frahncky/EMetrics-IoT/firmware/esp32_pzem/README.md

# ESP32 + PZEM-004T (MQTT)

Exemplo de firmware com provisionamento via AP local para receber Wi-Fi e MQTT direto do app.

## Estrutura

- esp32_pzem.ino

## Payload publicado

```json
{
  "voltage": 220.1,
  "current": 0.51,
  "power": 112.0,
  "pf": 0.98,
  "frequency": 60.0,
  "energy": 1.23,
  "temperature": 42.1,
  "crcErrors": 0,
  "timestamp": 1746316850000,
  "sequence": 7,
  "timeSynced": true,
  "storage": {
    "usingSd": true,
    "sdAvailable": true,
    "sdUsedBytes": 1048576,
    "sdTotalBytes": 33554432,
    "sdUsagePercent": 3.12
  }
}
```

- `timestamp` é o instante da medição em epoch de milissegundos. Vale `0`
  enquanto o NTP ainda não sincronizou; nesse caso `timeSynced` é `false`.
- `sequence` cresce a cada leitura e reinicia quando o ESP é reiniciado.
- `temperature` vale `null` quando a variante da placa não oferece sensor interno.

## Provisionamento pelo app

Quando o ESP nao tem configuracao salva, ele sobe em AP:

- SSID: EMetrics-Setup
- Senha: 12345678
- Endpoint de verificacao: GET /health
- Endpoint de configuracao: POST /provision

Campos esperados em /provision (form-urlencoded):

- ssid
- wifiPassword
- mqttHost
- mqttPort
- mqttUser
- mqttPassword
- mqttTopic
- mqttRequestTopic
- clientId
- useTls (1 ou 0)
- initialConnectTimeoutSeconds, retryIntervalSeconds e fallbackApDelaySeconds
  (opcionais; de 5 a 600 segundos)

O ESP32 tambem salva a rede Wi-Fi enviada em uma lista local. O app pode
gerenciar essa lista quando estiver conectado ao AP do ESP ou ao IP do ESP na
rede local:

- GET `/wifi-networks`: lista redes salvas.
- POST `/wifi-networks`: cria ou edita uma rede (`ssid`, `wifiPassword`,
  `oldSsid` opcional, `keepPassword` 1 ou 0).
- POST `/wifi-networks/delete`: exclui uma rede (`ssid`).
- POST `/wifi-networks/reorder`: muda a prioridade de uma rede (`ssid` e
  `direction`, com `up` ou `down`).
- GET `/wifi-connection-settings`: retorna os tempos de conexão Wi-Fi.
- POST `/wifi-connection-settings`: atualiza `initialConnectTimeoutSeconds`,
  `retryIntervalSeconds` e `fallbackApDelaySeconds` (de 5 a 600 segundos) e
  reinicia o ESP para aplicar a tentativa inicial.

O firmware mantém ate 5 redes salvas e tenta reconectar alternando entre elas
quando o Wi-Fi cai. A ordem exibida no app define a prioridade: a primeira
rede é sempre a primeira tentativa do próximo ciclo.

## AP de fallback

Depois da primeira configuracao, o ESP continua iniciando o servidor HTTP local.
Os valores padrão são: 20 segundos para a tentativa inicial, 15 segundos entre
tentativas e 60 segundos para ativar o AP de fallback. Eles podem ser alterados
no app, entre 5 e 600 segundos. Se o ESP ficar pelo tempo configurado sem
conseguir conectar em uma rede salva, ou se a lista de redes ficar vazia, ele
abre automaticamente o AP `EMetrics-Setup` em modo AP+STA. Nesse modo:

- O ESP continua tentando conectar nas redes salvas.
- O app pode acessar `http://192.168.4.1` para editar ou excluir redes.
- Ao reconectar na rede configurada, o AP de fallback e desligado sozinho.

Se o ESP iniciar sem nenhuma configuracao valida, ele entra no modo de
provisionamento inicial e permanece somente como AP ate receber `/provision`.

## Atualização de firmware por Wi-Fi (OTA)

A primeira gravação deste firmware ainda precisa ser feita via USB. Depois
disso, há duas formas de atualizar sem cabo:

### 1. Pelo Arduino IDE (ArduinoOTA)

Após a gravação inicial e o provisionamento do Wi-Fi, o ESP32 aparece
automaticamente como porta de rede no Arduino IDE:

**Tools > Port > `<clientId>` at `<IP>`**

Basta selecionar essa porta e clicar em **Upload** normalmente. Se a
`otaPassword` foi definida no provisionamento (8 a 64 caracteres), o IDE
solicitará a senha na primeira vez — informe a mesma chave. O hostname
exibido no IDE é o `clientId` definido no provisionamento (padrão:
`esp32_pzem_001`).

> **Requisito:** computador e ESP32 na mesma rede local.

### 2. Pelo app Flutter (HTTP OTA)

O firmware também expõe `POST /firmware/update` para receber um `.bin`
gerado para o ESP32. O app pode selecionar um `.bin` e enviá-lo pela rede
local. Cada upload deve enviar a chave OTA no cabeçalho HTTP
`X-EMetrics-OTA-Key`; sem ela, o ESP recusa a atualização.

Para gerar um binário com Arduino CLI:

```bash
arduino-cli compile --fqbn esp32:esp32:esp32 --export-binaries firmware/esp32_pzem
```

Use uma tabela de partições com duas partições OTA. O esquema padrão usado pelo
core ESP32 possui espaço para a atualização, desde que o `.bin` caiba na
partição de aplicação.

## Robustez incluida neste exemplo

- Configuracao persistida em NVS (Preferences)
- Reconexao nao bloqueante de Wi-Fi e MQTT
- AP de fallback para recuperar o acesso local quando a rede configurada cai
- Fila circular em RAM para segurar amostras durante queda do broker
- Envio em lote apos reconexao
- Historico persistente em cartao microSD (Adafruit) para replay sob demanda
- Fallback automatico para SPIFFS quando o cartao SD nao estiver disponivel
- Assinatura no topico de solicitacao de historico e reenvio por intervalo
- Suporte a MQTT com TLS (WiFiClientSecure)

## Armazenamento local (microSD Adafruit)

Por padrao, o firmware tenta iniciar o cartao SD no barramento SPI com os pinos:

- CS: `14`
- SCK: `18`
- MISO: `19`
- MOSI: `23`

Se sua placa usar outro mapeamento, altere no topo do arquivo `esp32_pzem.ino` via defines:

- `EMETRICS_SD_CS_PIN`
- `EMETRICS_SD_SCK_PIN`
- `EMETRICS_SD_MISO_PIN`
- `EMETRICS_SD_MOSI_PIN`

O arquivo de historico fica em `/history.log` e e usado para responder requisicoes de historico por intervalo.
O app tambem exibe o percentual de uso do SD a partir do campo `storage.sdUsagePercent`.

## Parametros de buffer (esp32_pzem.ino)

- TELEMETRY_QUEUE_CAPACITY: quantidade maxima de amostras na fila
- FLUSH_BATCH_LIMIT: quantas amostras enviar por iteracao do loop
- TELEMETRY_PAYLOAD_SIZE: tamanho maximo do JSON em bytes
- MQTT_BUFFER_SIZE: buffer do PubSubClient, incluindo JSON, tópico e cabeçalhos MQTT

Quando a fila lota, a amostra mais antiga e descartada para abrir espaco.

## Dependencias (Arduino IDE)

- WiFi (core ESP32)
- WebServer (core ESP32)
- Preferences (core ESP32)
- PubSubClient
- PZEM004Tv30

## Fluxo de uso

1. Grave o firmware no ESP32.
2. Conecte o celular na rede EMetrics-Setup.
3. No app, abra Configuracoes > MQTT > Provisionar ESP32.
4. Envie SSID/senha da rede final e dados do MQTT.
5. O ESP reinicia e passa a operar no modo normal.

## Controle pelo dashboard web

O botão **Iniciar nova leitura** fica no topo do dashboard. Ele limpa os
valores, gráficos, alertas e amostras da sessão atual no navegador e começa
uma nova coleta MQTT, sem apagar o histórico persistido no ESP32. Não é
necessário informar o endereço IP do dispositivo na interface web.

O painel também permite iniciar, pausar, retomar ou encerrar uma sessão de
coleta por um período definido em segundos. Esses controles registram as
leituras no gráfico do navegador e não interrompem a publicação MQTT do ESP32;
assim, pausar a coleta não acumula mensagens na fila do dispositivo.

## Observacao sobre QoS

Nesta implementacao (PubSubClient), a publicacao de payload usa QoS 0.
O app Flutter permanece compativel, pois consome o JSON publicado no topico configurado.

## Solicitar historico via MQTT

O firmware assina o topico configurado em `mqttRequestTopic` e espera o payload JSON:

```json
{
  "from": 1746230400000,
  "to": 1746316800000,
  "requestedAt": 1746316850000
}
```

Ao receber essa solicitacao, o ESP32 filtra os registros persistidos no intervalo `from`/`to`
e republica os payloads no topico principal de telemetria (`mqttTopic`).

## Configurar retencao do SD via MQTT

O mesmo topico `mqttRequestTopic` aceita um comando para ajustar por quantos dias o
historico fica armazenado no SD do medidor:

```json
{
  "command": "configureStorage",
  "sdRetentionDays": 30,
  "requestedAt": 1746316850000
}
```

O valor aceito fica entre 1 e 3650 dias. O firmware salva a configuracao em NVS
e remove registros do arquivo `/history.log` mais antigos que o periodo configurado.

## Observacao sobre TLS

Com `useTls=1`, o firmware usa `WiFiClientSecure` com `setInsecure()`.
Isso ativa criptografia de transporte, mas sem validacao de certificado do broker.
Para ambiente produtivo com validacao estrita, substitua por CA/certificado apropriado.
