frahncky/EMetrics-IoT/firmware/tabela_conexao.jpeg

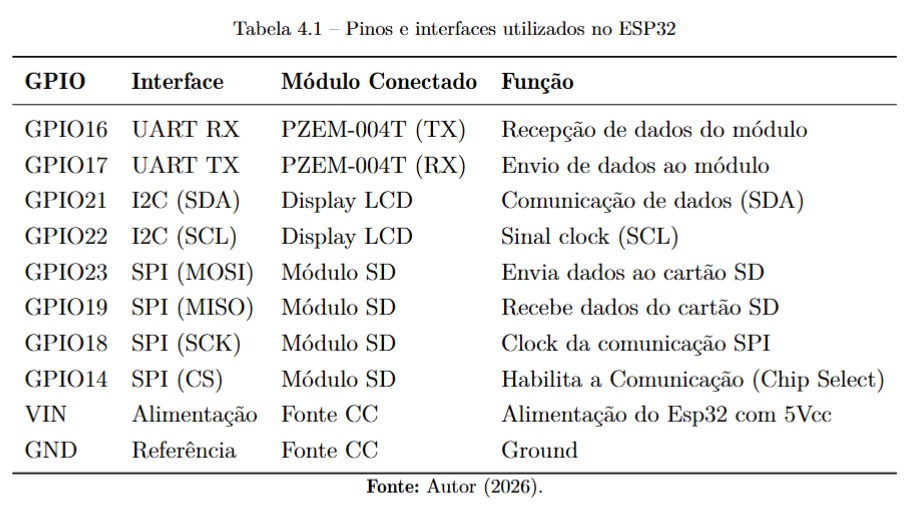
firmware/tabela_conexao.jpeg
