frahncky/EMetrics-IoT/imagens/PCB_design.png

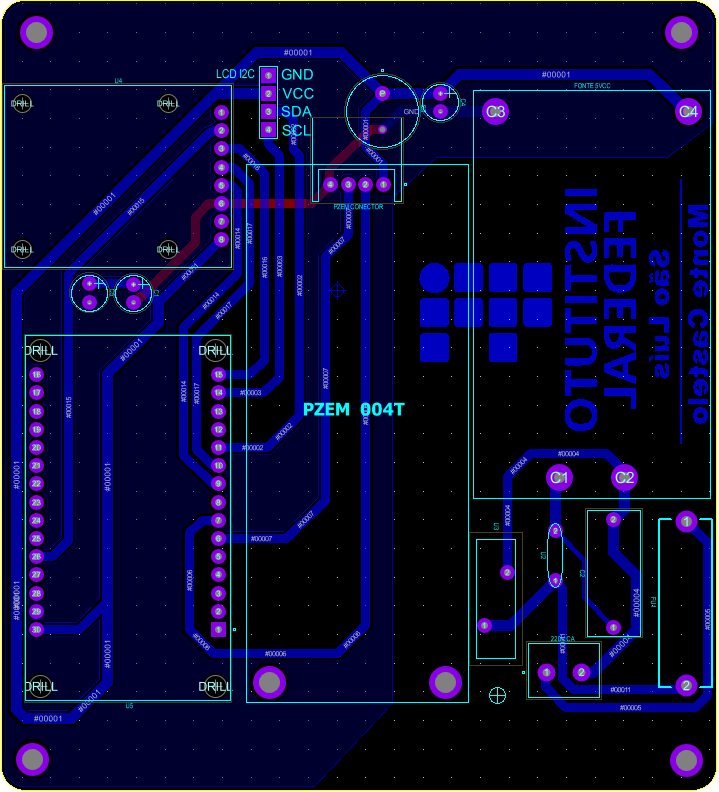
imagens/PCB_design.png
