frahncky/EMetrics-IoT/model_3D/Assembly 1.step

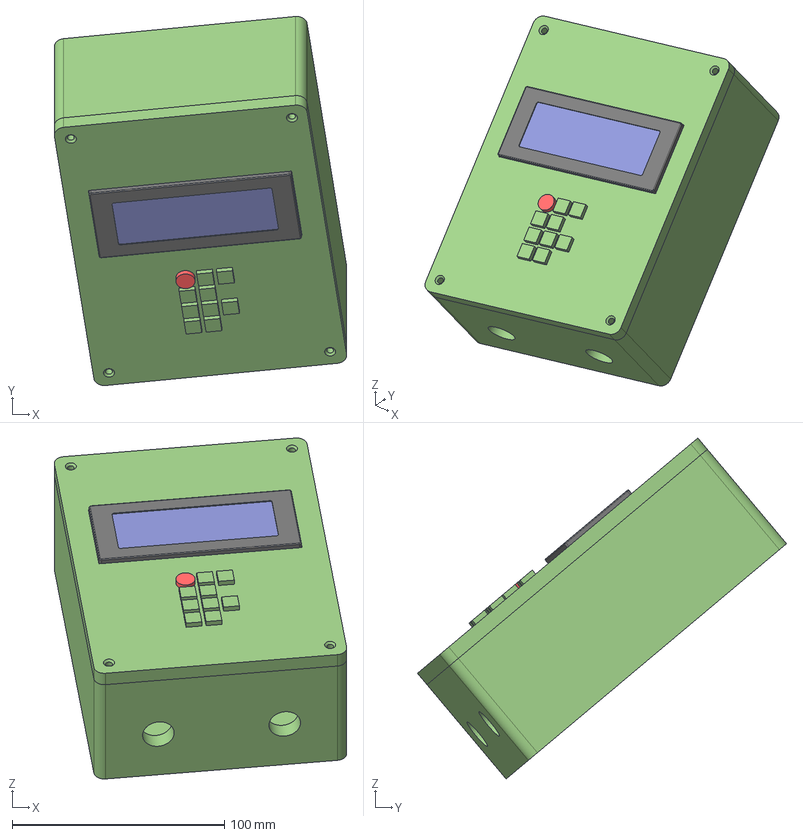
[picture p7: CAD file, 2026-07-03]
model_3D/Assembly 1.step
137.7 x 173.9 x 160.7 mm
4 way header curved x 4
20x4 LCD x 10
2 way header curved x 2
I2C LCD Adapter PCF8574
