frahncky/EMetrics-IoT/model_3D/Base.step

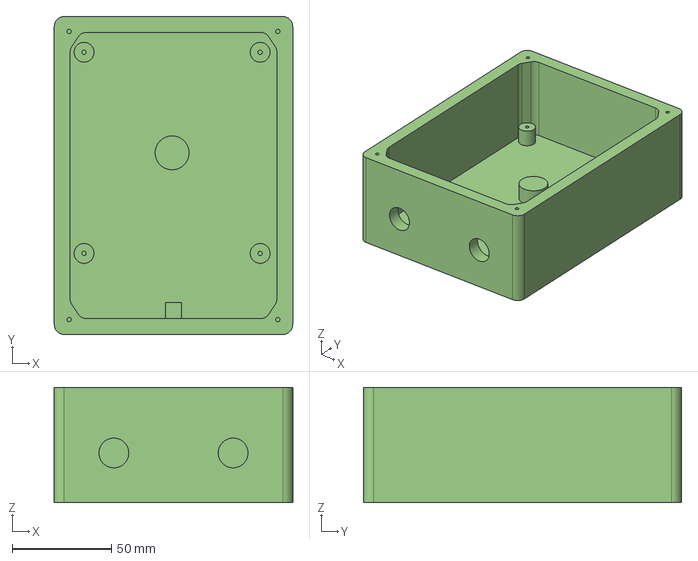
[picture p8: CAD file, 2026-07-03]
model_3D/Base.step
120.0 x 160.0 x 58.0 mm
