frahncky/EMetrics-IoT/imagens/montagem-case.png

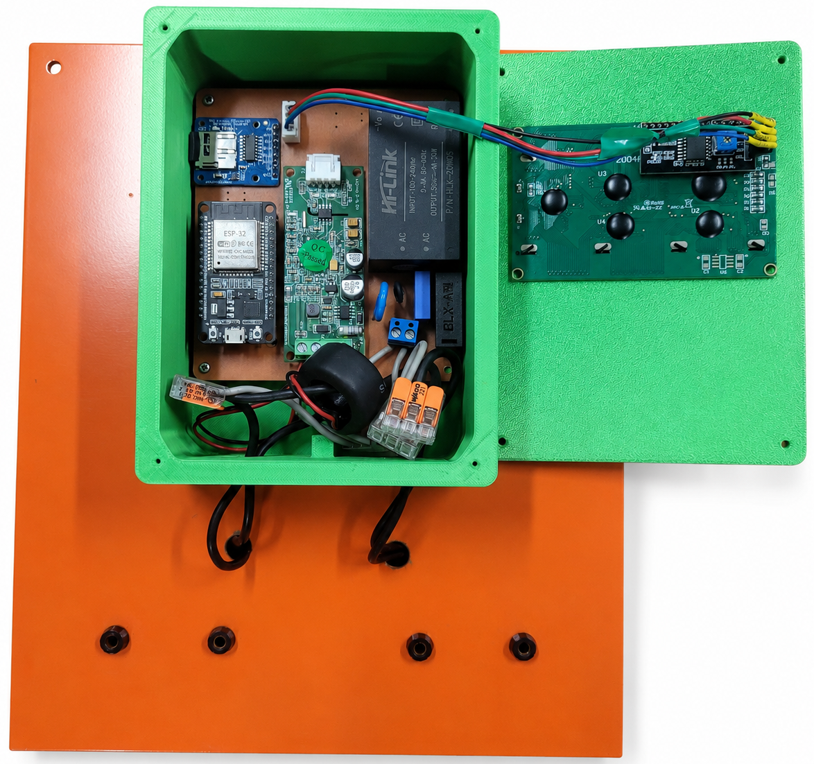
imagens/montagem-case.png
