frahncky/EMetrics-IoT/(list of files, drawings)

Other design files:
projeto_medidor_proteus/Medidor5_devikitV1.pdsprj
