frahncky/EMetrics-IoT/(commit log)

2026-04-28 Corrige erros de importação, nome de classe e estrutura do app principal. Ajusta teste para usar EmetricsApp.
2026-04-28 Melhorias visuais e acessibilidade: novos cards, drawer aprimorado, página de comparação de métricas, ajustes em temas e layouts.
2026-04-29 Corrige importação do EmetricsApp no teste e prepara projeto para execução sem erros.
2026-04-29 feat: commit geral de todas as alterações
2026-04-30 fix(dashboard): ajuste de ícones dos indicadores, especialmente tensão (Icons.electrical_services)
2026-04-30 Melhorias: formatação SI dinâmica, grid dos gráficos mais visível, e padronização da exibição de valores
2026-04-30 feat: responsividade dos indicadores com Wrap para melhor visualização em telas menores
2026-04-30 Melhorias de UI: bordas arredondadas no menu inferior, destaque amarelo no ícone selecionado, ajustes de splash e ícone do app, e padronização do nome para E-Metrics IoT.
2026-04-30 Corrige destaque amarelo de fundo no ícone selecionado do menu inferior (BottomNavigationBar).
2026-05-01 feat: improve history UI and add mqtt history request flow
2026-05-01 feat: adicionar tema claro/escuro dinâmico e ajustar espaçamento de botões
    - Criar theme provider com Riverpod para controlar modo claro/escuro
    - Persistir preferência de tema em SharedPreferences
    - Definir tema claro baseado em estilo branco/azul (imagem fornecida)
    - Manter tema escuro com cores originais (preto/amarelo)
    - Remover cores hardcoded dos botões para responder ao tema dinamicamente
    - Aumentar espaçamento do botão Conectar em relação ao menu inferior
    - Rótulo do switch agora mostra 'Modo claro' ou 'Modo escuro' dinamicamente
2026-05-01 fix: adaptar cores hardcoded para usar tema claro/escuro dinamicamente
    - Alterar history_chart.dart para usar backgroundColor e cores de grid do tema
    - Alterar history_page.dart para dropdown color responder ao tema
    - Alterar realtime_chart.dart para usar theme colors em vez de hardcoded
    - Alterar dashboard_page.dart para usar scaffoldBackgroundColor e colorScheme
    - Corrigir deprecação withOpacity para withValues em todos os arquivos
2026-05-01 style: melhorar tema claro/escuro com paleta de cores moderna de qualidade visual
    Tema Claro:
    - Background: #F5F7FA (branco muito claro com tom azulado)
    - Primary: #0066FF (azul vibrante)
    - Secondary: #00B4D8 (azul cyan moderno)
    - Cards: branco puro #FFFFFF com bordas sutis
    - AppBar: branco puro com sombra de 4px
    - Inputs: melhor contraste com bordas coloridas no focus
    - Textos: cinzentos refinados para melhor legibilidade
    Tema Escuro:
    - Background: #0F1419 (preto muito escuro)
    - Primary: #00D8FF (ciano vibrante)
    - Secondary: #FFB300 (amarelo warmth)
    - Cards: #1A202C com bordas de 1px
    - AppBar: #1A202C com sombra aumentada
    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
2026-05-01 style: reduzir cansaço visual do tema claro com cores mais suaves
    Tema Claro melhorado:
    - Background: #FAFBFC (quase branco, muito suave)
    - Primary: #4A7BA7 (azul cinzento, menos vibrante)
    - Secondary: #6BA3C5 (azul suave)
    - Cards: #FFFEFB (branco com tom quente suave)
    - Textos: cinzentos mais suaves para menos contraste
    - Grid lines: muito mais sutis (6% e 3% de opacidade)
    - Sombras: reduzidas para visual mais clean
    - AppBar: sombra reduzida para 2px
    O tema claro agora é mais confortável para uso prolongado!
2026-05-01 fix: remover parâmetro key não utilizado de classe privada _MainMenu
    - Remover {super.key} do construtor de _MainMenu já que é classe privada
    - Todas as classes privadas não precisam aceitar key de fora
    - Corrige último lint warning de unused_element_parameter
    - Agora 0 issues no flutter analyze
2026-05-01 feat: validar configurações MQTT e reforçar tratamento de erros
2026-05-01 style: melhorias de design - gradientes no AppBar e animações nos cards
2026-05-01 Ajusta seleção de grandezas e unidade dinâmica nos gráficos
2026-05-01 Atualiza rótulo de frequência no dashboard
2026-05-01 Refactor: remove side effects from build and serialize MQTT writes
    - Move ref.read(alertProvider) from build() to ref.listen() to avoid side
    effects in render cycle (improves code correctness per Riverpod best practices)
    - Add serialization to MQTT metric writes using Future chaining to prevent
    race conditions during high-frequency message ingestion
    - Implement debounce (100ms) for invalidations to batch provider updates
    instead of triggering recomputes for each message
    No functional changes to user-facing behavior. All 26 tests pass.
2026-05-01 Ajusta largura do botão de histórico
2026-05-01 Refina largura do botão de histórico
2026-05-01 Feat: configurações de medição e alertas personalizáveis
    - Novo provider MeasurementSettingsProvider (SharedPreferences) com
    voltageMin, voltageMax, energyLimitKwh e tariffPerKwh
    - AlertProvider agora usa os valores configurados pelo usuário em vez
    de limites hardcoded (200/240 V, 10 kWh)
    - Seção 'Medição e alertas' na página de configurações com campos
    validados (tensão mín/máx, limite consumo, tarifa)
    - Validação cruzada: tensão máxima deve ser maior que a mínima
    - Exportação de histórico refatorada com stubs por plataforma
    (io/web/stub) para compatibilidade multiplataforma
    - 31 testes passando (5 novos para settings_validators e
    measurement_settings_provi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
2026-05-01 UI: compacta botão de solicitação e alinha com Exportar CSV na mesma linha
    - Ícone alterado de download para sync (mais semântico para solicitar dados)
    - Texto reduzido de 'Solicitar histórico do medidor' para 'Solicitar do medidor'
    - Botões 'Solicitar do medidor' e 'Exportar CSV' agora na mesma linha (Row)
    - Exportar CSV movido para fora do callback de dados para ficar sempre visível
2026-05-01 Fix: atualiza texto do botão no teste de solicitação de histórico
2026-05-02 Refine settings action buttons and dashboard status UI
2026-05-02 Add optional login flow with guest mode and auth gate
2026-05-02 Harden background MQTT credentials flow and async notifier safety
2026-05-02 Unify MQTT channel flow and rename auth UI to local profiles
2026-05-02 Request notification permission during MQTT connect flow
2026-05-02 feat: adicionar tres tipos de potencia nos graficos e firmware ESP32/PZEM MQTT
2026-05-02 feat: provisionamento ESP32 via AP HTTP, tela no app e dependencia HTTP
2026-05-03 chore: ajustar nivel de log no CMake do Windows
2026-05-03 feat: roadmap MVP - sync REST offline, perfis MQTT, dashboard persistente, previsao local e OAuth Device Flow
2026-05-03 feat: backend de exemplo Node.js/Express para receber metricas REST
2026-05-03 fix: corrige overflow e label do dropdown de perfil na aba MQTT
2026-05-03 docs: adiciona CHANGELOG, manual do usuario e politica de seguranca
2026-05-03 docs: completa manual com formato do payload MQTT e secao de historico
2026-05-03 chore: padroniza nomenclatura de dispositivo e ajustes na UI
2026-05-03 feat(firmware): adiciona TLS, replay de historico e build Arduino
2026-05-03 feat(firmware): armazenamento de historico em microSD com fallback SPIFFS
2026-05-03 refactor: boas praticas, AppColors, docstrings e comentarios de secao
2026-05-04 docs: atualizar README com melhorias de UX
2026-05-04 fix: validar credenciais MQTT antes de autenticar
2026-05-04 fix: definir hierarquia de atuacao dos icones MQTT
2026-05-04 fix(ui): restaurar tamanho do ícone de raio no AppBar para 28
2026-05-05 Ajusta ícones de status MQTT e medidor
2026-06-17 Fix dashboard overflow and ESP wiring
2026-06-17 Reorganize ESP32 firmware sketch
2026-06-17 Add LCD 4x20 I2C display support with rotating metrics
2026-06-23 refactor: remove reset de energia do provisionamento
2026-06-23 Adiciona controles web de coleta e energia
2026-06-23 Adiciona atualização OTA pelo Arduino IDE
2026-06-23 fix: substitui esp_wpa2.h por esp_eap_client.h (deprecated no ESP32 core 3.x)
    [esp32_pzem.ino]
2026-06-23 Melhora dashboard: energias acumuladas, reset via MQTT e status em tempo real
    - Gráficos web sempre acumulam dados independente do timer de coleta
    - Botão de zerar energia envia comando via MQTT em vez de HTTP ao IP do ESP
    - Zerar limpa o histórico local e os gráficos do app junto com o kWh do PZEM
    - Cards de Aparente e Reativa passam a exibir kVAh e kVArh acumulados
    - Ícone de status do ESP no app atualiza a cada segundo sem precisar trocar de tela
    - Corrige deprecation esp_wpa2.h -> esp_eap_client.h no firmware
2026-06-23 Add chart PNG downloads and ESP32 firmware v2
2026-06-23 Adiciona cards configuráveis e temperatura ao dashboard
    - Segurar qualquer card abre seletor para trocar a grandeza exibida
    - Layout dos cards persiste entre sessões via shared_preferences
    - Temperatura do ESP32 disponível nos cards e nos gráficos (tempo real e histórico)
    - Corrige label FP (era Fator P.)
2026-06-23 Adiciona metadados de temperatura nos gráficos (título, unidade e cor)
2026-06-23 Adiciona temperatura na lista do seletor de gráficos do dashboard
2026-06-23 Corrige recorte e adiciona formatos PNG/JPG/EPS no download de gráficos
    - Usa getBBox() para medir bounds reais do SVG (incluindo rótulos que transbordam),
    eliminando o recorte que ocorria com padding fixo
    - Adiciona download em JPEG (qualidade 0.92) e EPS (PostScript Level 3 com JPEG
    embutido via DCTDecode/ASCIIHexDecode), além do PNG já existente
    - Substitui botão único por grupo de três botões PNG / JPG / EPS em cada ChartCard
2026-06-23 Corrige recorte usando getBoundingClientRect nos elementos do SVG ao vivo
    Substitui a abordagem getBBox() em container oculto por uma varredura de todos
    os descendentes do SVG enquanto renderizados na tela. getBoundingClientRect()
    captura posições reais incluindo labels rotacionadas (angle=-24 no BarChart) que
    transbordam o viewport. O overflow em pixels de tela é convertido para unidades
    SVG via fator px→ux e aplicado ao viewBox antes de serializar.
2026-06-24 Refatora listeners do app, centraliza config e expande testes widget
    - Cria AppConfig com constantes antes espalhadas (debounce, intervalos, broker padrão)
    - Cria appBootstrapProvider consolidando os 7 ref.listen de _AppInitializer em um ponto único
    - Simplifica app.dart para um único ref.watch(appBootstrapProvider)
    - Adiciona 5 novos testes widget do dashboard: layout, valor de métrica, diálogo de reset, cancelamento e seletor de grandeza
2026-06-24 Adiciona backoff exponencial, exceções tipadas, linting e melhorias web
    Flutter:
    - MqttService.connectWithRetry() com backoff exponencial (2s→60s, 5 tentativas)
    - AppDatabaseException tipada envolve erros SQLite no MetricRepository
    - analysis_options.yaml com regras adicionais: use_super_parameters,
    avoid_dynamic_calls, unnecessary_lambdas, prefer_single_quotes e outros
    Dashboard web:
    - ErrorBoundary isola crashes React evitando derrubada total da app
    - mqttService.js: backoff exponencial no reconnect (2s→30s, dobra a cada falha)
    - utils.js extrai err/fmt/sign/computeStats/formatDuration/parseCsvToData do App.jsx
    - utils.test.js: 13 novos testes cobrindo todos os utilitários (total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
2026-06-24 Corrige clipping dos rótulos rotacionados no download do gráfico de barras
    getBoundingClientRect() devolve coordenadas clipadas pelo viewport do SVG,
    mascarando o overflow dos rótulos do eixo X com angle={-24}. A nova abordagem
    usa getBBox()+getScreenCTM() que opera no espaço geométrico pré-clipping,
    detectando corretamente a extensão real dos rótulos rotacionados.
2026-06-24 Corrige regressão no export do gráfico de barras: exclui <defs> do cálculo de bounds
    getBBox em elementos dentro de <defs> (clipPath, gradientes) retorna coordenadas
    em espaço de definição, inflando o viewBox e comprimindo o gráfico exportado.
    Adicionado `el.closest("defs, clipPath, mask")` para excluí-los.
    Também usa .recharts-legend-icon para capturar cores da legenda de forma mais
    precisa em BarChart (fill como atributo SVG específico do ícone).
2026-06-24 Simplifica detecção de overflow: overflow:visible temporário em vez de getBBox
    A abordagem getBBox+getScreenCTM causava regressões com elementos SVG de
    containers (<g>) cujos getBBox acumulam filhos em espaços de coordenadas
    inesperados. Solução: revelar overflow do SVG ao vivo antes de medir com
    getBoundingClientRect(), que força reflow síncrono e retorna posições reais
    (sem clipping) de rótulos rotacionados. Mais simples e sem casos especiais.
2026-06-27 Atualiza download em lote de graficos web
2026-06-27 Corrige exportacao de graficos vazios
2026-06-27 Separa intervalos de telemetria: medição, SD e MQTT independentes
    Firmware e app agora suportam três intervalos configuráveis separadamente
    (measurementIntervalMs, sdLogIntervalMs, mqttPublishIntervalMs) em vez de
    um único publishIntervalMs. Adiciona struct PzemReading para cache de leituras
    e novo comando MQTT configureIntervals; mantém retrocompatibilidade com
    setPublishInterval legado.
2026-06-27 Adiciona aba Configurações no dashboard web
    Permite enviar comandos MQTT ao dispositivo diretamente pelo browser:
    intervalos de telemetria independentes (medição/SD/MQTT), retenção do
    SD card e Wi-Fi híbrido. Tópico de comandos configurável e persistido
    no localStorage.
2026-06-27 Sincroniza valores da aba Configurações com o ESP32
    Firmware passa a incluir campo \"config\" no payload de telemetria com os
    intervalos atuais, retenção SD e estado do Wi-Fi híbrido. Dashboard lê
    esses valores na primeira leitura recebida e pré-preenche os campos.
    Aumenta TELEMETRY_PAYLOAD_SIZE 512→768 e MQTT_BUFFER_SIZE 768→1024
    para acomodar o payload expandido.
2026-06-28 Remove controle de coleta; adiciona navegação histórica nos gráficos
    Remove AcquisitionControls e toda a lógica de sessão de coleta.
    Adiciona componente Brush do Recharts em todos os gráficos ao vivo,
    permitindo arrastar para ver dados históricos. Buffer de histórico
    aumentado de 60 para 300 pontos. Botão substituído por Limpar histórico.
2026-07-01 handle capacitive phasor direction
2026-07-03 docs: adiciona autores para citacao e sincroniza alteracoes
2026-07-05 web: remove fator de potencia do diagrama fasorial
